khanhnm08/HK_Pulse_Rate_Sensor/Image/image_v2.jpg

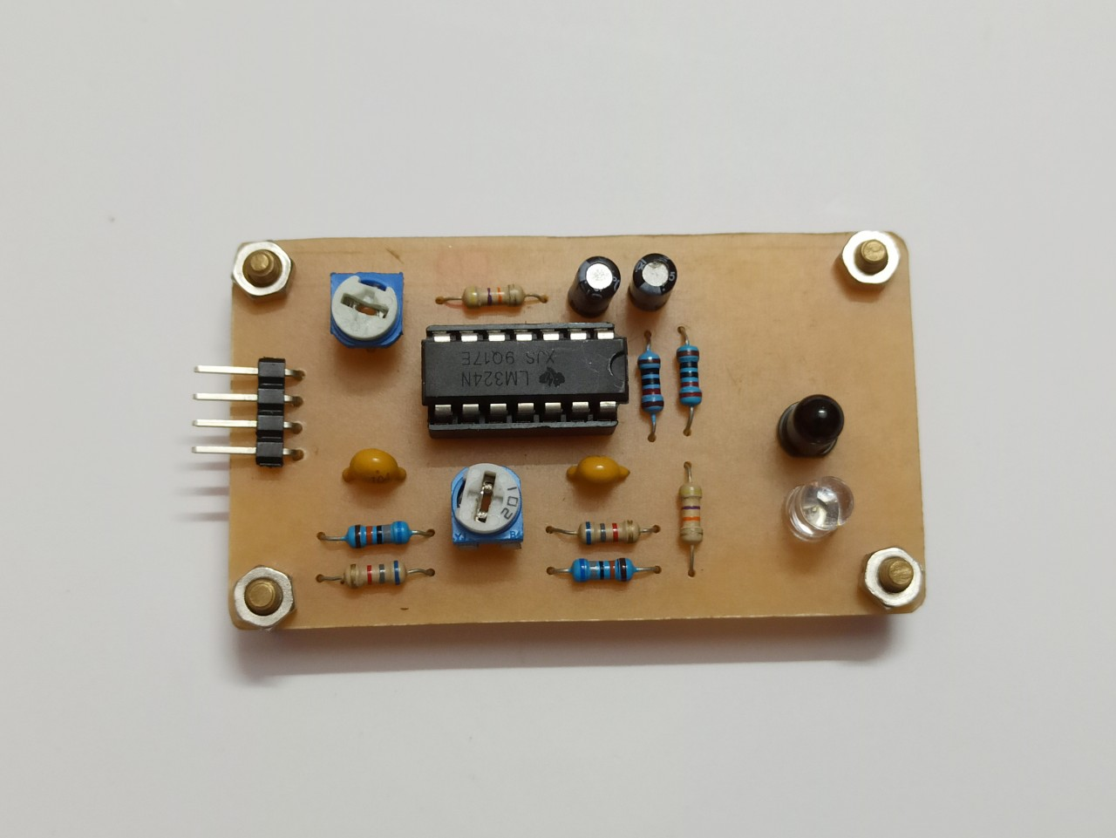
Image/image_v2.jpg
