khanhnm08/HK_Pulse_Rate_Sensor/README.md

# HK_Pulse_Rate_Sensor

Cảm biến phát hiện nhịp tim

Demo video v1: https://drive.google.com/file/d/1G4Am2tvlFR1gyaoi4kLDOHLQvKz7ClXj/view?usp=sharing

Demo video v2: https://drive.google.com/file/d/1ZpMukO9I2sv0ZALf7AAjrvjhI45IQpxu/view?usp=sharing
