khanhnm08/HK_Pulse_Rate_Sensor/Image/9952f7d47343861ddf52.jpg

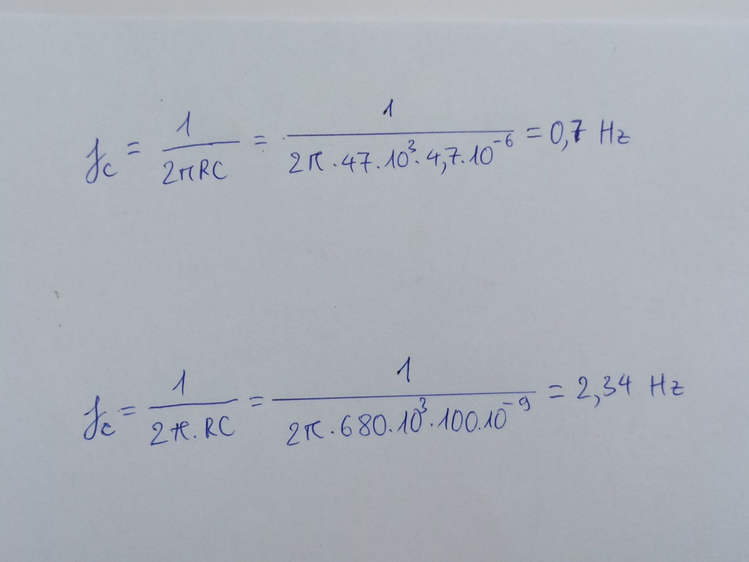
Image/9952f7d47343861ddf52.jpg
