khanhnm08/HK_Pulse_Rate_Sensor/Image/IR Reciver LEd.jpg

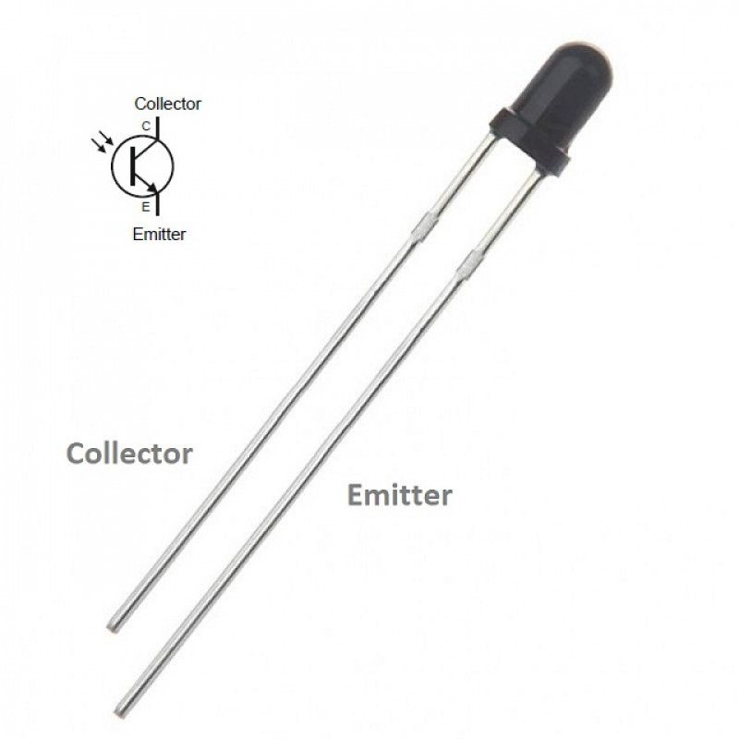
Image/IR Reciver LEd.jpg
