khanhnm08/HK_Pulse_Rate_Sensor/Image/phototransistor.png

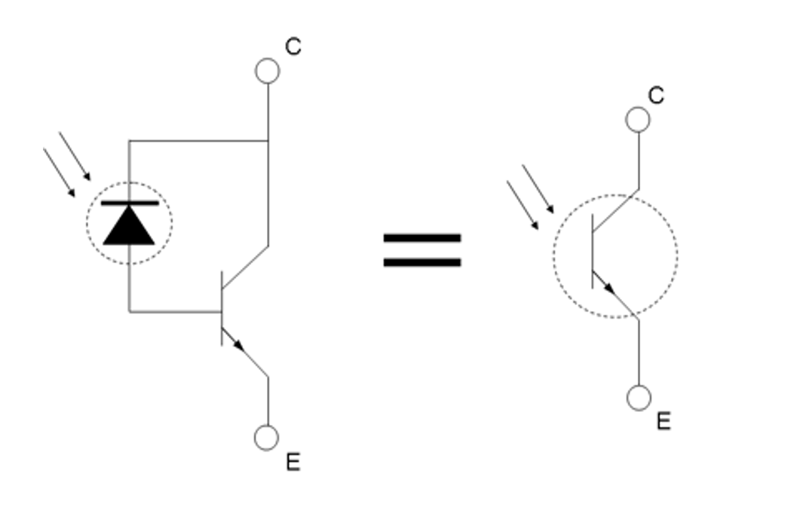
Image/phototransistor.png
