khanhnm08/HK_Pulse_Rate_Sensor/Image/Untitled.png

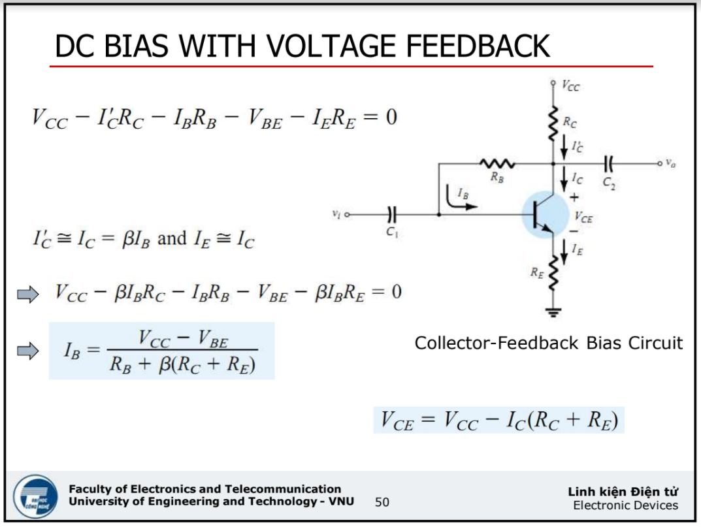
Image/Untitled.png
