khanhnm08/HK_Pulse_Rate_Sensor/Schematic_Pulse Rate Sensor.pdf

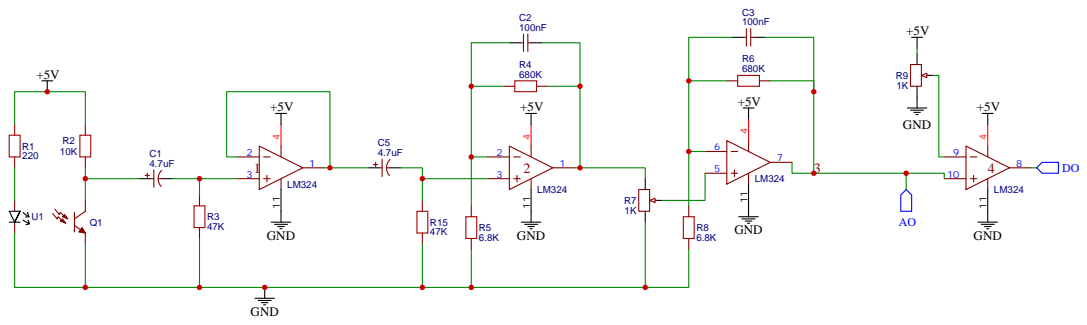
[picture p21: page 1]

Drawn By: Ngo Minh Khanh

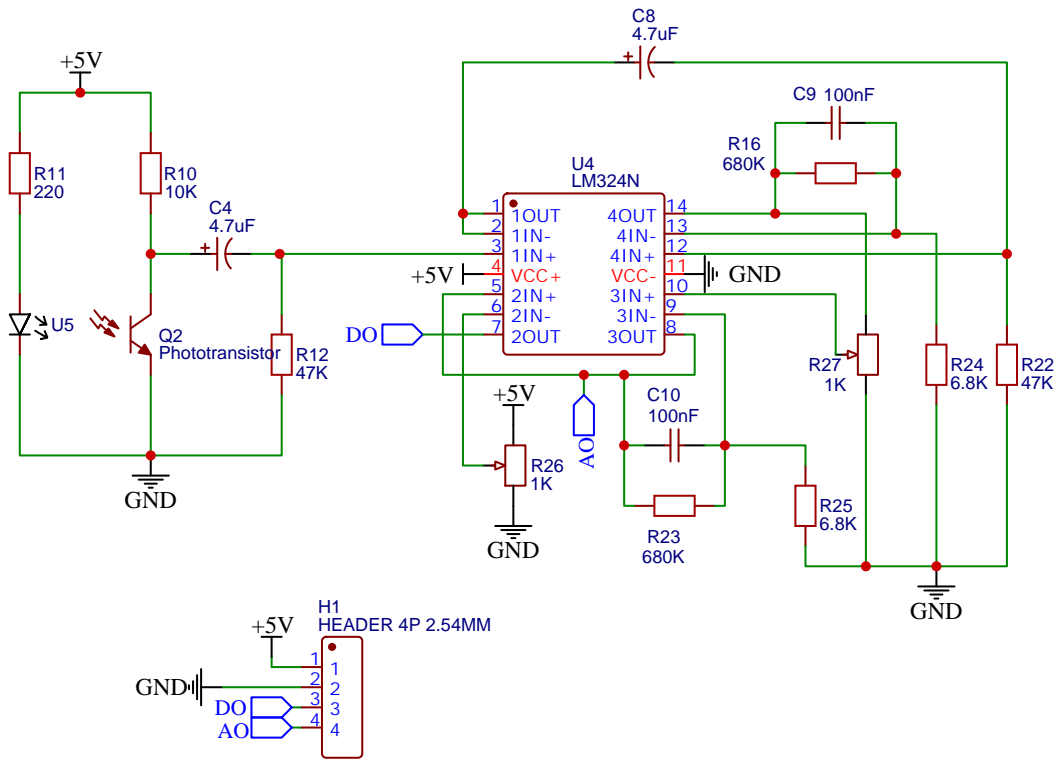
[picture p22: page 2]

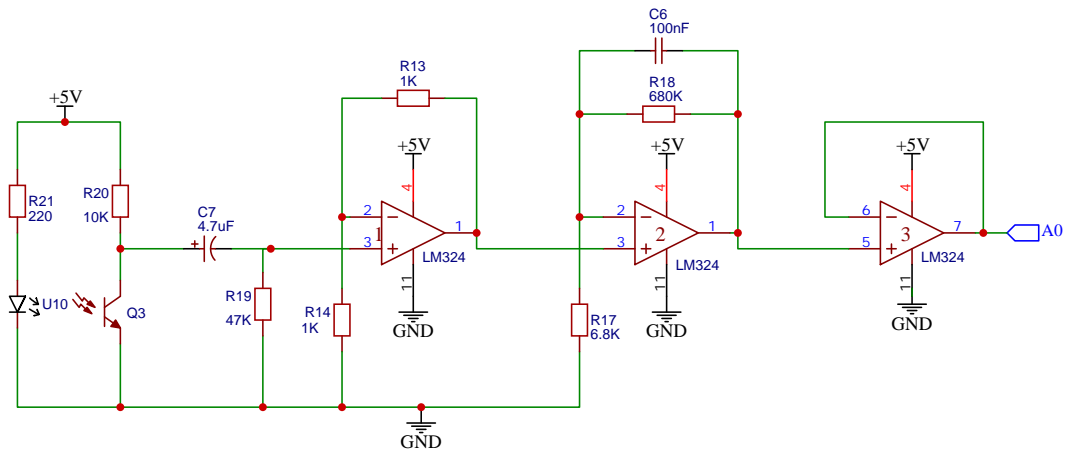
[picture p23: page 3]
