khanhnm08/HK_Pulse_Rate_Sensor/(list of files, drawings)

Other design files:
PCB_Pulse Rate Sensor.pcbdoc
